m2i/LTA_KillBoard/2-Hardware/Kill_Board/Calculations/SenseDividerCalc.jpg

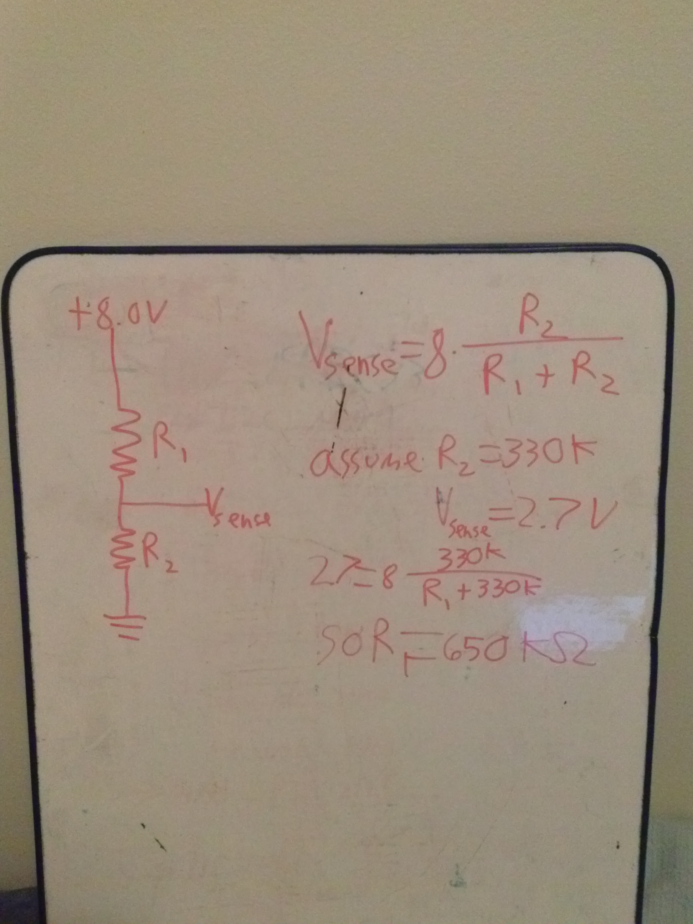
2-Hardware/Kill_Board/Calculations/SenseDividerCalc.jpg
