m2i/LTA_KillBoard/README.md

LTA_KillBoard
=============

A dedicated power board for the Freshman 160 LTA's which provides power distribution and kill switch capabilities.
