m2i/LTA_KillBoard/4-Production/ISU_LTA_Kill_Board-RevD-DigikeyPrices.pdf

Parts | Part Number/Keyword
Quick Links: View Order | Order Status | Contact Us | Site Map | Change Country
My Digi-Key | Newest Products | Product Index | Supplier Index | Resources
Web ID 47850259 Access ID 18181 Salesorder Number Uncommitted | Logout

Pricing is valid for this Web ID until 8/17/2013 if you place your order online

If you need to find a part number, use the search box in the upper right of the page or click the icon here.
If you know exactly what you want, fill in the quantity, part number, and optional customer reference number below and select Add to Order.
Quantities are not reserved until the order has been submitted. You will be reminded of backorder quantities at submit time. Available quantities may have changed due to real time inventory. To check current availability, click the "Update Stock Status" button below.
Quantity | Part Number | Customer Reference
| | | Add to Order

Click on the Part Number to MODIFY or DELETE an item from your order.

All prices are in US dollars.
Index | Quantity | Part Number | Description | Customer Reference | Available Quantity | Backorder Quantity | Unit Price | Extended Price
1 | 4 | 311-1141-1-ND | CAP CER 0.1UF 25V 10% X7R 0805 | "C1 C2 C4 C5" | 4 Immediate | 0 | 0.12000 | $0.48
2 | 1 | 445-5984-1-ND | CAP CER 10UF 25V 10% X5R 0805 | "C3" | 1 Immediate | 0 | 0.70000 | $0.70
3 | 1 | 754-1141-1-ND | LED 3.2X1.6MM 568NM GRN CLR SMD | "D1" | 1 Immediate | 0 | 0.20000 | $0.20
4 | 1 | 754-1142-1-ND | LED 3.2X1.6MM 640NM RED CLR SMD | "D2" | 1 Immediate | 0 | 0.20000 | $0.20
5 | 1 | FDC6333CCT-ND | MOSFET N-CH/P-CHAN 30V SSOT6 | "Q1" | 1 Immediate | 0 | 0.46000 | $0.46
6 | 2 | 568-6587-1-ND | MOSFET N-CH 30V 75A D2PAK | "Q2 Q3" | 2 Immediate | 0 | 3.06000 | $6.12
7 | 9 | P330ACT-ND | RES 330 OHM 1/8W 5% 0805 SMD | "R1 R2 R3 R4 R5 R6 R7 R8 R11" | 9 Immediate | 0 | 0.10000 | $0.90
8 | 1 | P330KCCT-ND | 1/8W 1% 0805 SMD RES 330K OHM | "R10" | 1 Immediate | 0 | 0.10000 | $0.10
9 | 1 | P649KCCT-ND | 1/8W 1% 0805 SMD RES 649K OHM | "R9" | 1 Immediate | 0 | 0.10000 | $0.10
10 | 1 | EG1940-ND | DPDT .2A L=4MM SWITCH SLIDE | "S1" | 1 Immediate | 0 | 0.73000 | $0.73
11 | 1 | LM2937IMP-3.3/NOPBCT-ND | IC REG LDO 3.3V 0.4A SOT223 | "U1" | 1 Immediate | 0 | 1.85000 | $1.85
12 | 1 | 296-18588-1-ND | IC LTCH D-TYP SGL 3-OUT SOT-23-6 | "U2" | 1 Immediate | 0 | 0.40000 | $0.40
13 | 2 | S5751-10-ND | CONN RECEPT 2MM SINGLE STR 10POS | "XB1" | 2 Immediate | 0 | 1.11000 | $2.22
Subtotal | $14.46
Shipping | Estimate
Sales Tax | unknown
Total | unknown

## Update Stock Status

Are you shipping outside the United States?

Online Ordering | Digi-Key | http://www.digikey.com/classic/Ordering/AddPart.aspx?s...
1 of 2 | 07/18/2013 11:52 PM
