m2i/LTA_KillBoard/4-Production/ISU_LTA_Kill_Board-RevD-Schematic.pdf

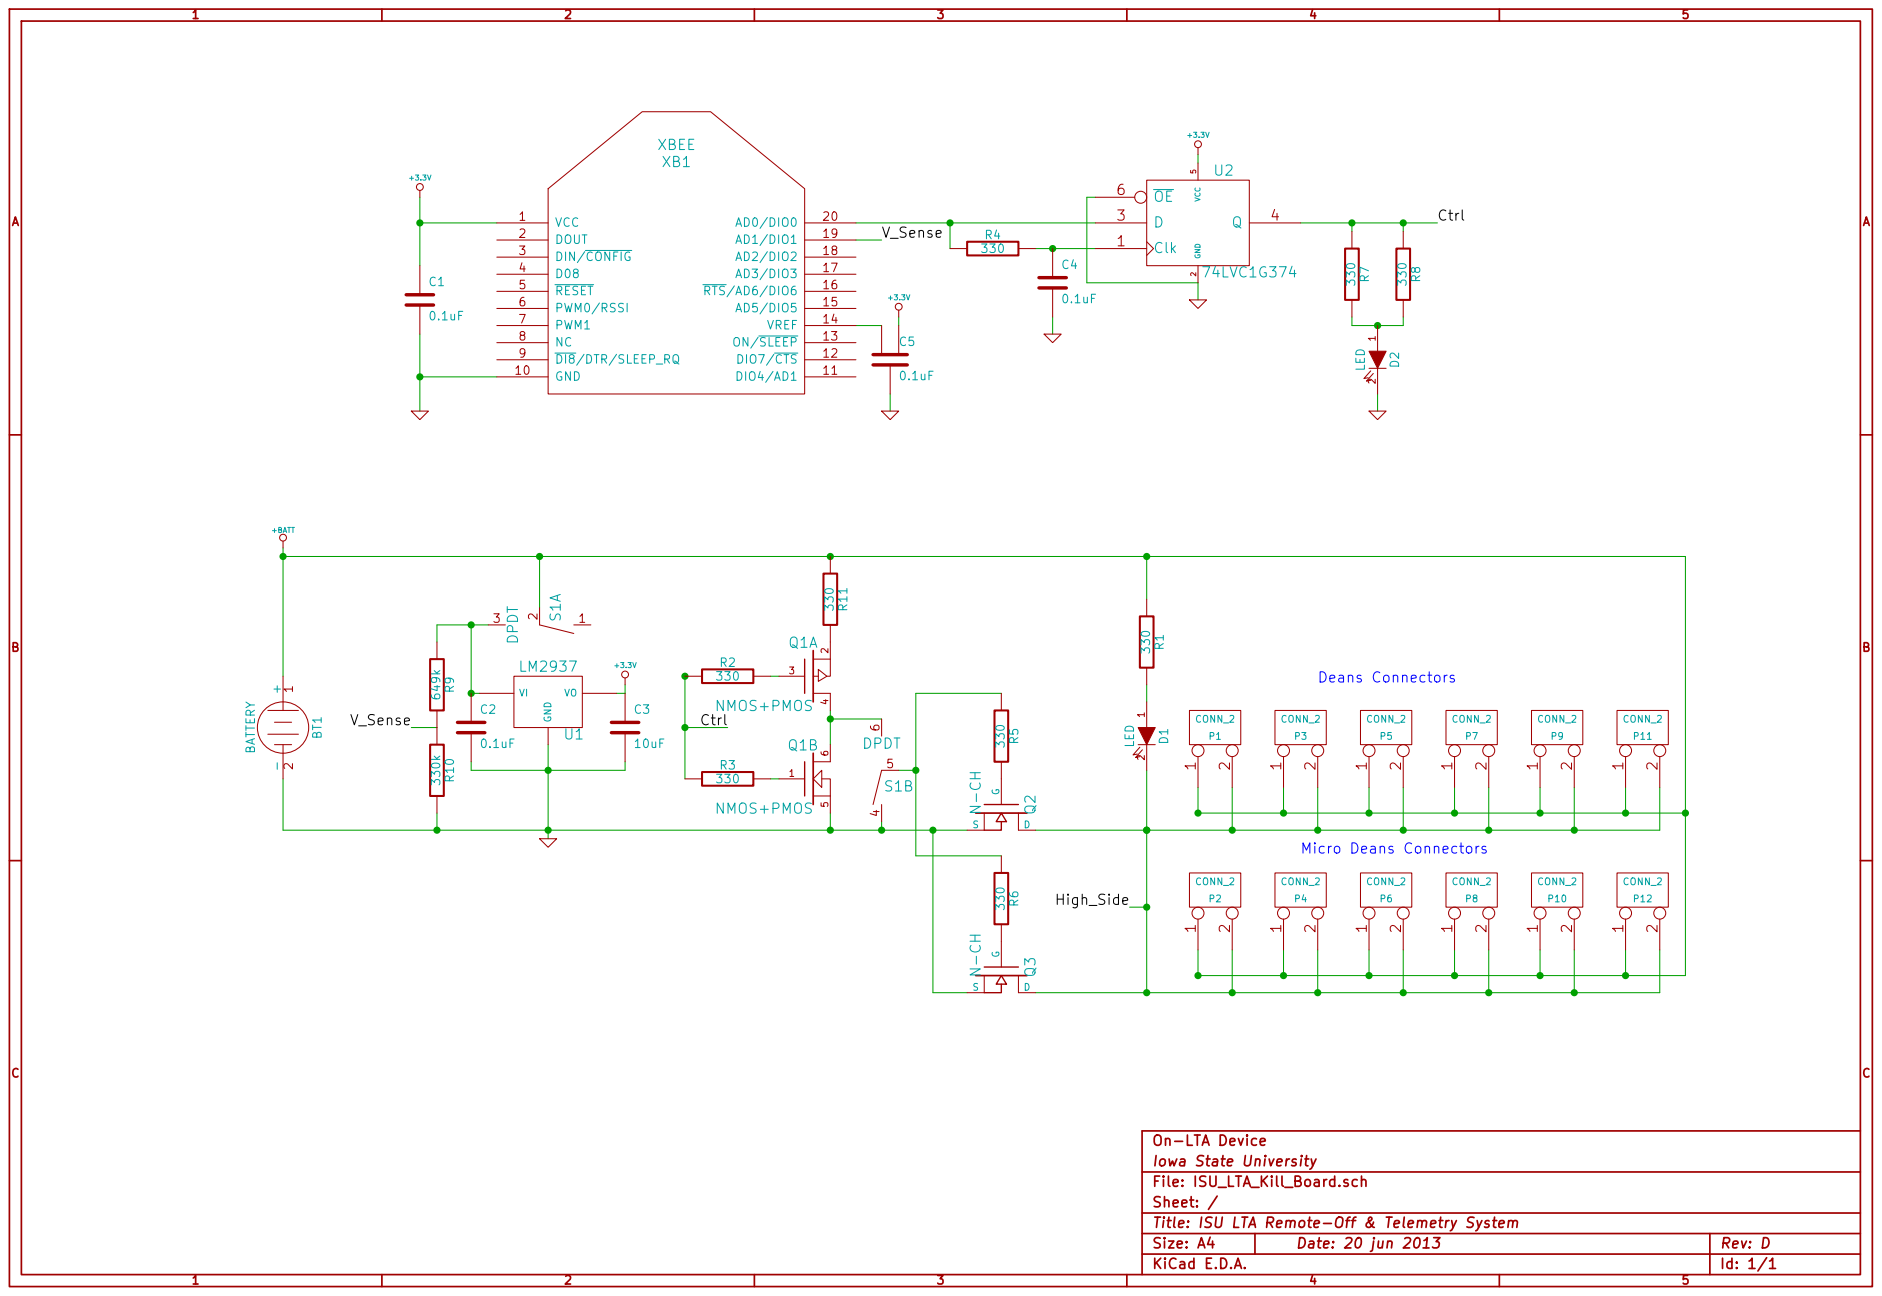
[picture p2: page 1]

On-LTA Device
Iowa State University
File: ISU_LTA_Kill_Board.sch
Sheet: /
Title: ISU LTA Remote-Off & Telemetry System
KiCad E.D.A.
