m2i/LTA_KillBoard/2-Hardware/Kill_Button/ISU_LTA_Kill_Button.pdf

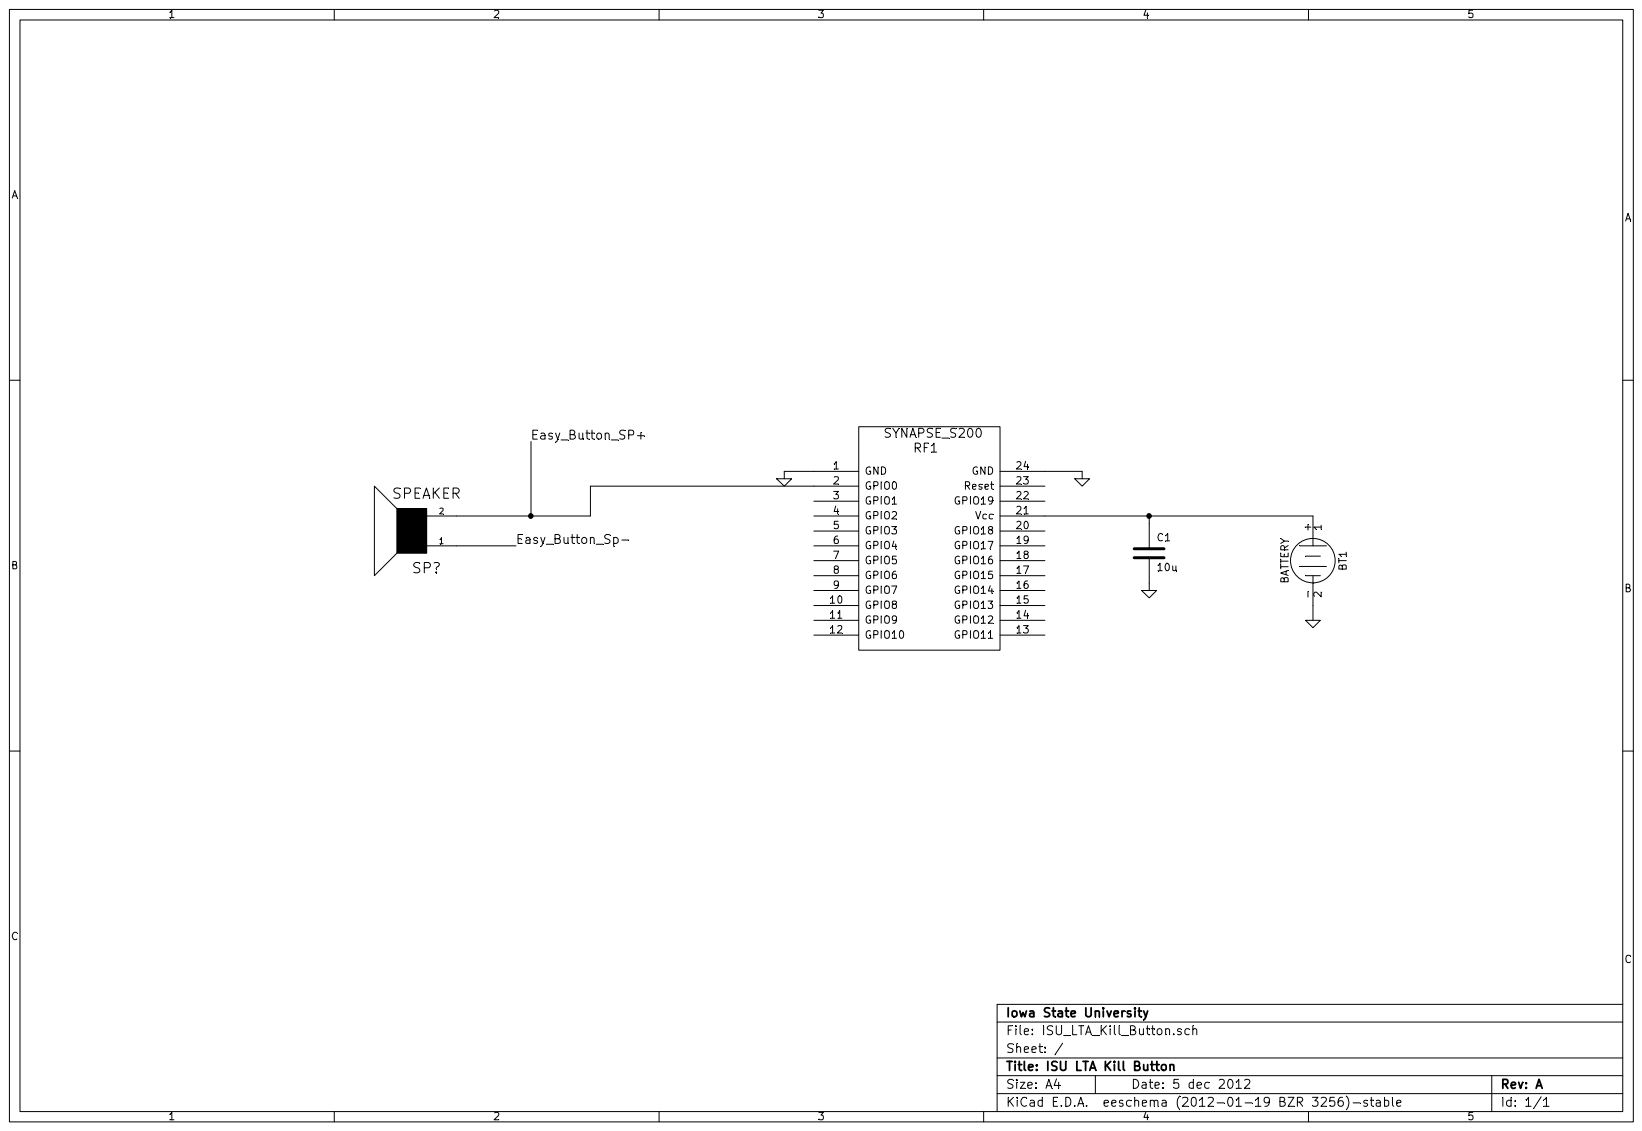
[picture p3: page 1]
