m2i/LTA_KillBoard/2-Hardware/Kill_Button/ISU_LTA_Kill_Switch.pdf

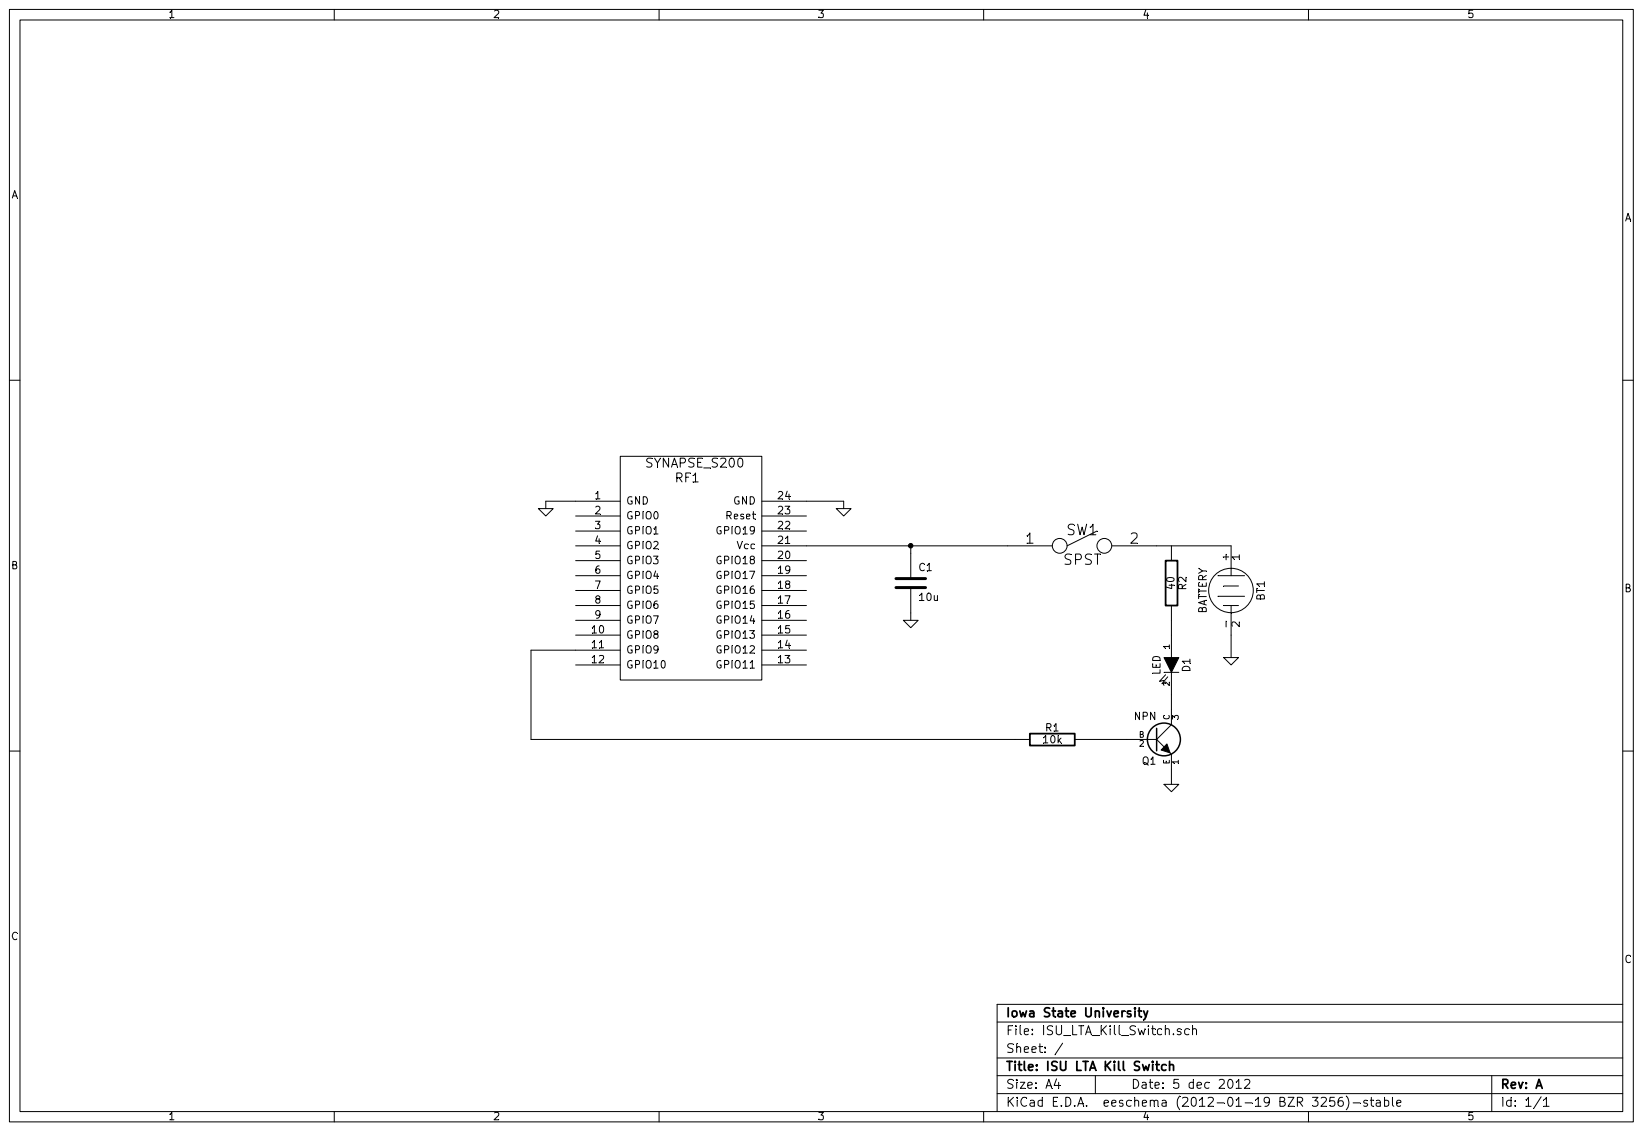
[picture p4: page 1]
