m2i/LTA_KillBoard/2-Hardware/Kill_Board/ISU_LTA_Kill_Board.sch

## KiCad design 2-Hardware/Kill_Board/ISU_LTA_Kill_Board.sch (2013-10-10)

Schematic: ISU_LTA_Kill_Board.sch

Parts:
BT1: BATTERY
C1, C2, C4, C5: 0.1uF; DigikeyNumber 311-1141-1-ND
C3: 10uF; DigikeyNumber 445-5984-1-ND
D1: LED; DigikeyNumber 754-1141-1-ND
D2: LED; DigikeyNumber 754-1142-1-ND
P1, P2, P3, P4, P5, P6, P7, P8, P9, P10, P11, P12: CONN_2
Q1: NMOS+PMOS; DigikeyNumber FDC6333CCT-ND
Q2, Q3: N-CH; DigikeyNumber 568-6587-1-ND
R1, R2, R3, R4, R5, R6, R7, R8, R11: 330; DigikeyNumber P330ACT-ND
R9: 649k; DigikeyNumber P649KCCT-ND
R10: 330k; DigikeyNumber P330KCCT-ND
S1: DPDT; DigikeyNumber EG1940-ND
U1: LM2937; DigikeyNumber LM2937IMP-3.3/NOPBCT-ND
U2: 74LVC1G374; DigikeyNumber 296-18588-1-ND
XB1: XBEE; DigikeyNumber S5751-10-ND

Notes on the sheet:
Deans Connectors
Micro Deans Connectors
