m2i/LTA_KillBoard/2-Hardware/Kill_Button/ISU_LTA_Kill_Button.sch

## KiCad design 2-Hardware/Kill_Button/ISU_LTA_Kill_Button.sch (2013-10-10)

Schematic: ISU_LTA_Kill_Button.sch

Parts:
BT1: BATTERY
C1: 10u
RF1: SYNAPSE_S200
