m2i/LTA_KillBoard/2-Hardware/Kill_Button/ISU_LTA_Kill_Switch.sch

## KiCad design 2-Hardware/Kill_Button/ISU_LTA_Kill_Switch.sch (2013-10-10)

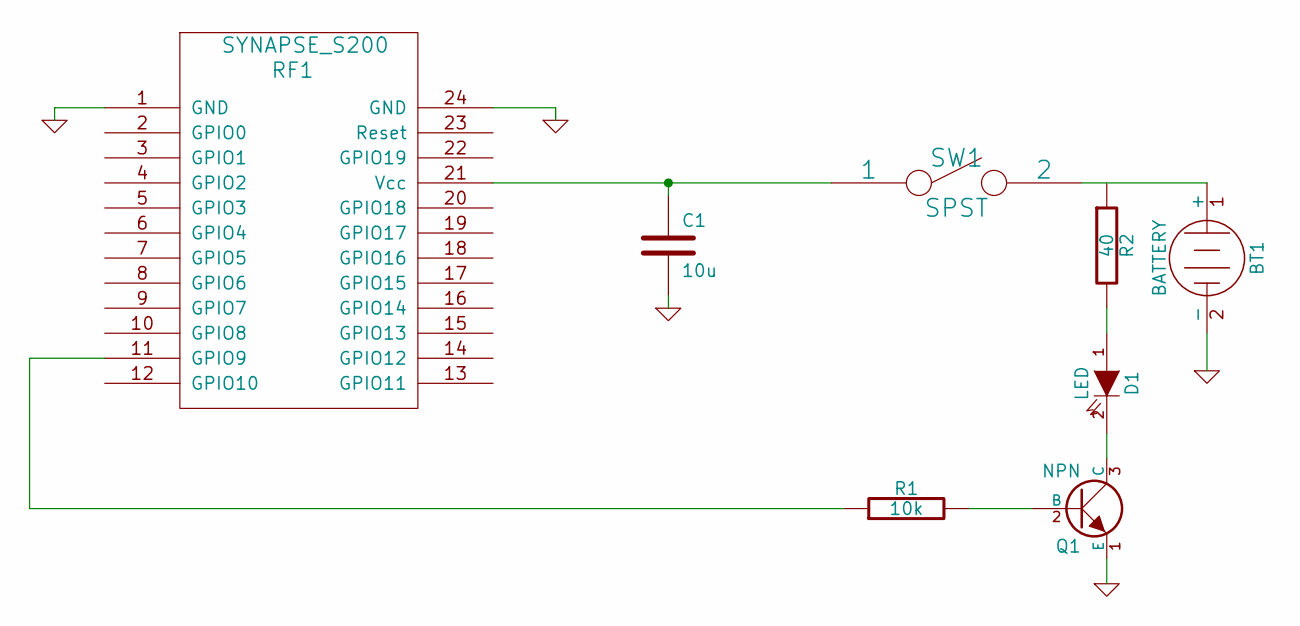
[picture p5: schematic ISU_LTA_Kill_Switch.sch]

Parts:
BT1: BATTERY
C1: 10u
D1: LED
Q1: NPN
R1: 10k
R2: 40
RF1: SYNAPSE_S200
SW1: SPST

Connections:
GND: BT1.2 (-), C1.2, Q1.1 (E), RF1.1 (GND), RF1.24 (GND)
unnamed: BT1.1 (+), SW1.2
unnamed: C1.1, RF1.21 (Vcc), SW1.1
unnamed: D1.1 (A), R2.2
unnamed: D1.2 (K), Q1.3 (C)
unnamed: Q1.2 (B), R1.2
unnamed: R1.1, RF1.11 (GPIO9)
