m2i/LTA_KillBoard/(threads)

Thread 1 (2017-03-21):

Add Feather board

matgyver, 2017-03-21:
Add for the Adafruit Feather board that can be plugged in.  Several of the digital I/Os need to be mapped to connectors that can be used for the IR detectors and IR LEDs.

Thread 2 (2017-03-21):

LED Driver

matgyver, 2017-03-21:
The IR LEDs can draw up to 100 mA.  In order to get the maximum brightness from these, we will need a LED driver circuit to drive these
