m2i/LTA_KillBoard/3-Firmware/snappyImages/LTA_Kill_Button.py

from pinWakeupATmega128RFA1 import *

# Tell the script where to find the Portal to log the data
PORTAL_ADDR = '\x00\x00\x01'

# Pin the switch is connected to
BUTTON_PIN = 0

@setHook(HOOK_STARTUP)
def startupEvent():
    # Set SM200 Pin F1 to be an input pin
    setPinDir(BUTTON_PIN, False)
    setPinPullup(BUTTON_PIN, False)
    monitorPin(BUTTON_PIN, True)
    rpc(PORTAL_ADDR, "logEvent", loadNvParam(8) + " has been turned on")
    
@setHook(HOOK_GPIN)
def button_pressed(pin, isSet):
    if pin == BUTTON_PIN:
        rpc(PORTAL_ADDR, "logEvent", loadNvParam(8) + " is killing LTAs")
        mcastRpc(0x0002, 3, 'kill_LTA')
        
@setHook(HOOK_1S)
def second_timer():
    rpc(PORTAL_ADDR, "LTA_Check_In")
