m2i/LTA_KillBoard/(commit log)

2013-10-10 Initial commit of the files.
    [ISU_LTA_Kill_Board-BOM.csv, ISU_LTA_Kill_Board-RevD-BOM.csv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]
2013-12-10 Updated the battery cutoffs and the battery voltage display values.
